intergalaktik/ulx5-PCIe-1x/README.md

# Work in progress!!! 

# ULX-PCIe
GateMate FPGA on PCIe card

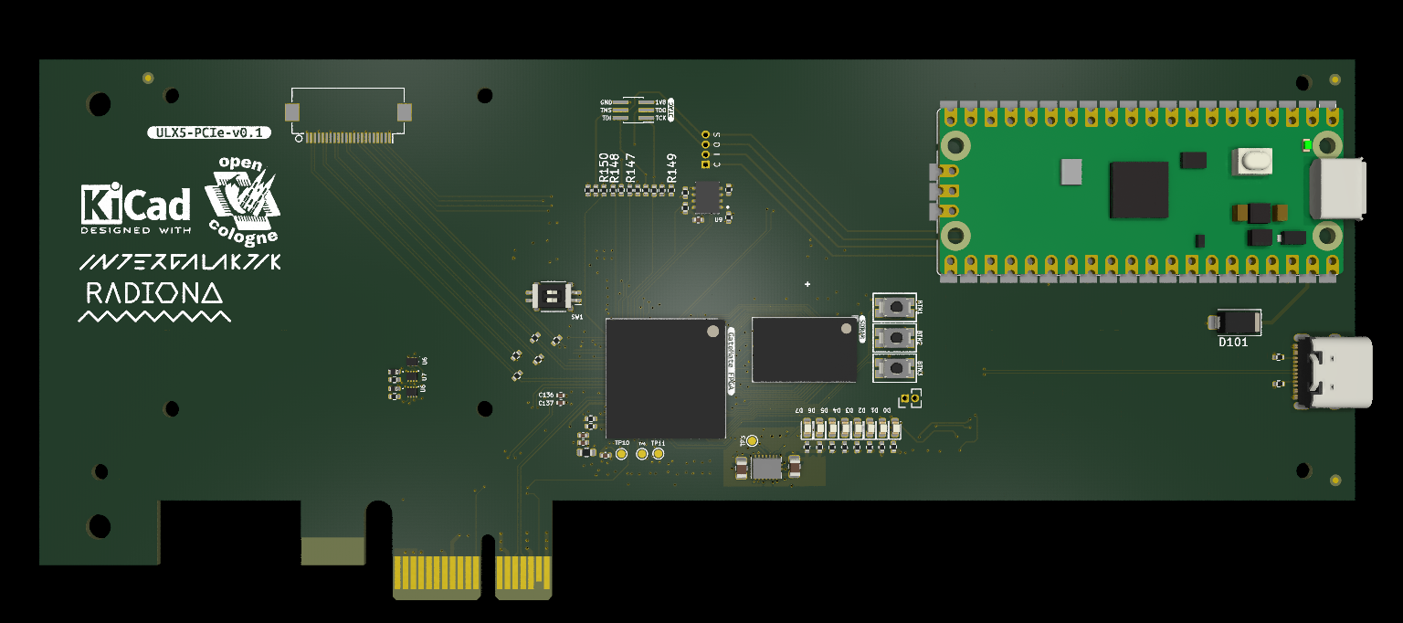
[picture p1: pic/PCIe_1X.png]
PCIE


## References

https://github.com/intergalaktik/ulx5m-gs

https://github.com/OLIMEX/GateMateA1-EVB

https://github.com/intergalaktik/Extension_Boards_for_Olimex_GateMate

https://github.com/YosysHQ/prjpeppercorn-test-cases

https://github.com/YosysHQ/prjpeppercorn
  
https://github.com/chili-chips-ba/openCologne

https://www.chili-chips.xyz/open-cologne

## Acknowledgements

This project was done in collaboration with Chili Chips*Ba team. 
They have put enormes effort in making all cores to work on GateMate even before we have our own board!
Thanks to them now we have big set of cores that can be used to check and improve opensource toolchain!
They are proven to be reliable partners that solves problem quickly and on side works on educating younger generations!
Also big thanks goes to YosysHQ as they are doing miracles with open source tooling, and we now finaly have one that works for GateMate!
From YosysHQ special thanks to Micko and Lofty that are helping in real time on Discord!
Special thanks to Patrick from Cologne, as without him and rest of Cologne team we would not be able to get this project done.

## Work on this board is financed by NLnet foundation

NLnet

https://nlnet.nl/project/openCologne/

https://nlnet.nl/project/OpenCologne-PCIe/

https://github.com/chili-chips-ba/openCologne-PCIE

This project was funded through the NGI0 Commons Fund, a fund established by NLnet with financial support from the European Commission's Next Generation Internet programme, under the aegis of DG Communications Networks, Content and Technology under grant agreement No 101135429. Additional funding is made available by the Swiss State Secretariat for Education, Research and Innovation (SERI).

## Check up our blogposts
Comming soon!!!

## Contact us

Discord: https://discord.gg/qwMUk6W
