intergalaktik/ulx5-PCIe-1x/ulx5-PCIe-1x.pdf

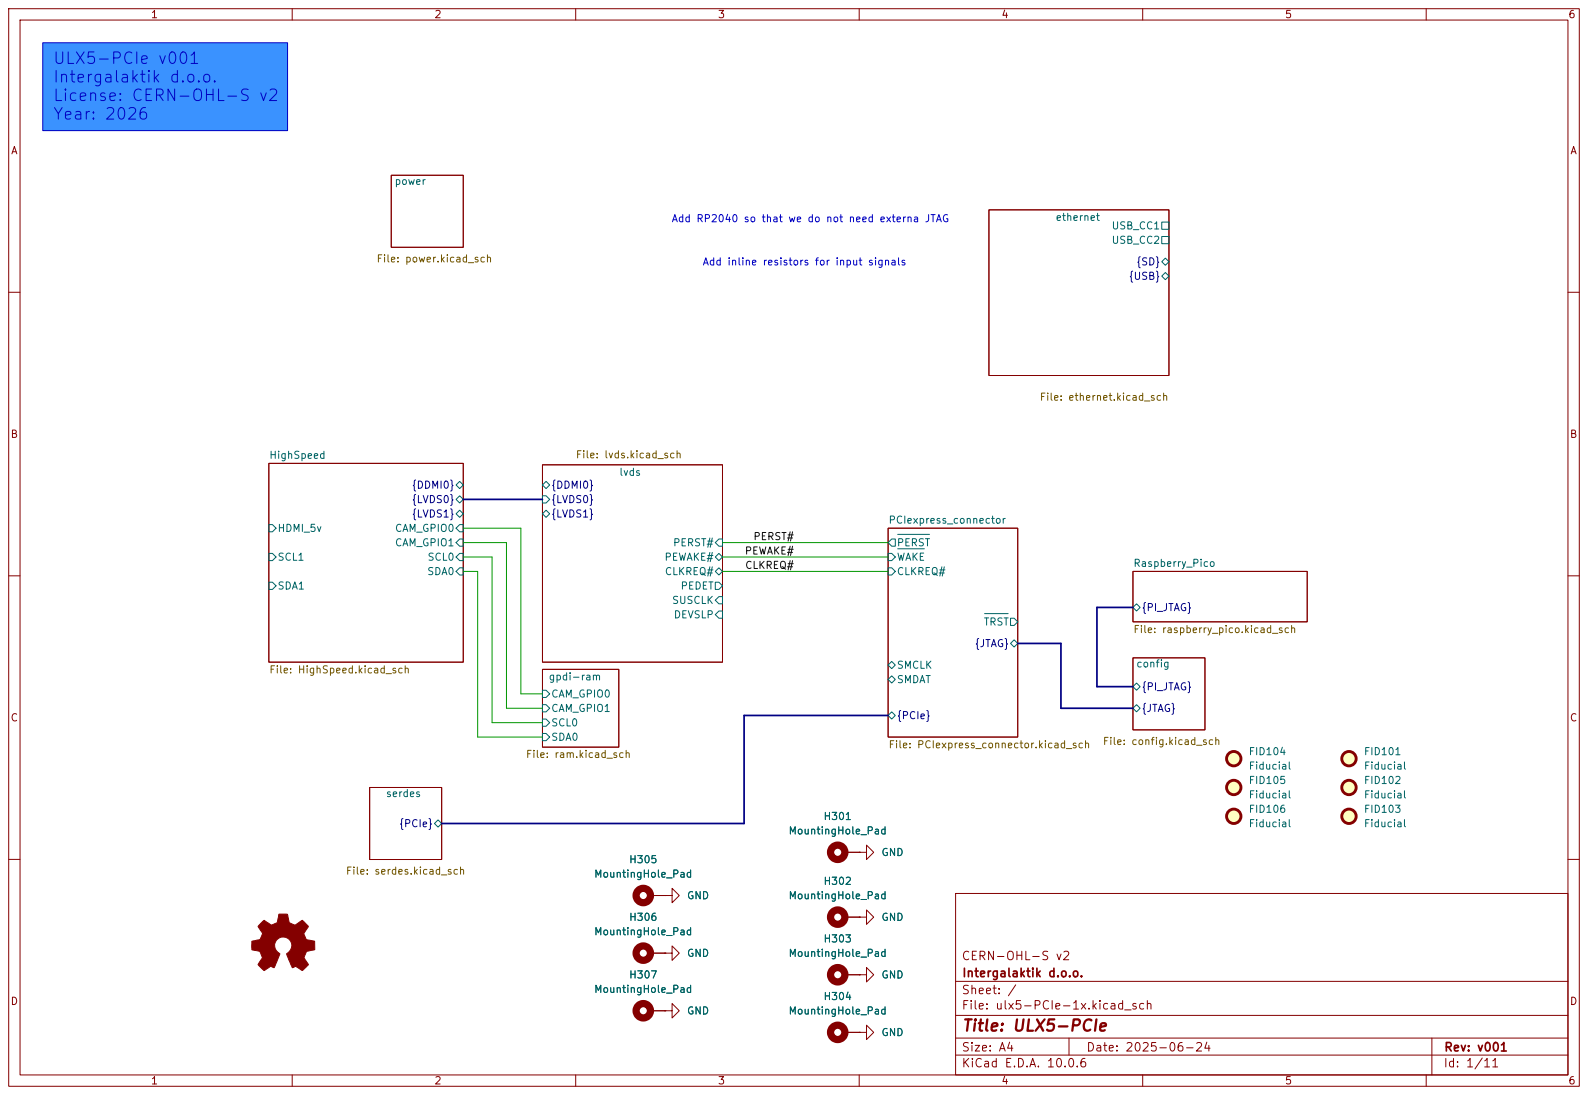
[picture p2: page 1]

Add RP2040 so that we do not need externa JTAG Add inline resistors for input signals H301 MountingHole_PadGND H302 MountingHole_PadGND
lvds File: lvds.kicad_sch CAM_GPIO0 CAM_GPIO1

{USB} ethernet File: ethernet.kicad_sch CLKREQ#

{PCIe} serdes File: serdes.kicad_sch

Size: A4 | Rev: v001
KiCad E.D.A. 10.0.6 | Id: 1/11

1 | 2 | 3 | 4 | 5 | 6 1 | 2 | 3 | 4 | 5 | 6 ABCD | ABCD Date: 2025-06-24

## Title: ULX5-PCIe

### File: raspberry_pico.kicad_sch

### Sheet: /Raspberry_Pico/

Intergalaktik d.o.o.

### CERN-OHL-S v2

# +3V3D301 D_Schottky GND

GND

GPIO0 1 | GPIO1 2 | GND 3 GPIO2 4 | GPIO3 5 | GPIO4 6 | GPIO5 7 | GPIO6 9 | GPIO7 10 | GPIO8 11 | GPIO9 12 | GPIO10 14 | GPIO11 15 | GPIO12 16 | GPIO13 17 | GPIO14 19 | GPIO15 20 | GPIO16 | 21 GPIO17 | 22 GPIO18 | 24 GPIO19 | 25 GPIO20 | 26 GPIO21 | 27 GPIO22 | 29 RUN 30 | GPIO26_ADC0 | 31 GPIO27_ADC1 | 32
AGND | 33 GPIO28_ADC2 | 34
ADC_VREF | 35 3V3 36
3V3_EN 37 | VSYS 39 | VBUS 40

SWCLK D1

SWDIO D3 | USB_GND | TP1 USB_DM | TP2 USB_DP | TP3
SMPS_PS | TP4
LED_OUT | TP5 BOOTSEL TP6
A101 RaspberryPi_Pico {PI_JTAG} | RST_N

FPGA_GPIO1

FPGA_UART_TX

FPGA_GPIO2

FPGA_UART_RX | GPIO10 | GPIO20 GPIO16 GPIO26 GPIO28 GPIO27 GPIO19 GPIO18 GPIO22 GPIO14 GPIO15 GPIO12 GPIO13 GPIO9 GPIO11 GPIO8 GPIO6 GPIO7 GPIO0 | GPIO21 GPIO20 | GPIO1 GPIO2 PI_TCK

PI_TDI PI_TDO

GPIO3 GPIO5 GPIO12 GPIO22 GPIO21 PI_TMS GPIO13GPIO17 GPIO18 GPIO16 GPIO19 | GPIO4 | GPIO17 GND
A101 RaspberryPi_Pico GPIO0 1 | GPIO1 2 | GND 3 GPIO2 4 | GPIO3 5 | GPIO4 6 | GPIO5 7 | GPIO6 9 | GPIO7 10 | GPIO8 11 | GPIO9 12 | GPIO10 14 | GPIO11 15 | GPIO12 16 | GPIO13 17 | GPIO14 19 | GPIO15 20 | GPIO16 | 21 GPIO17 | 22 GPIO18 | 24 GPIO19 | 25 GPIO20 | 26 GPIO21 | 27 GPIO22 | 29 RUN 30 | GPIO26_ADC0 | 31 GPIO27_ADC1 | 32
AGND | 33 GPIO28_ADC2 | 34
ADC_VREF | 35 3V3 36
3V3_EN 37 | VSYS 39 | VBUS 40

SWCLK D1

SWDIO D3 | USB_GND | TP1 USB_DM | TP2 USB_DP | TP3
SMPS_PS | TP4
LED_OUT | TP5 BOOTSEL TP6 | D301 D_Schottky +3V3

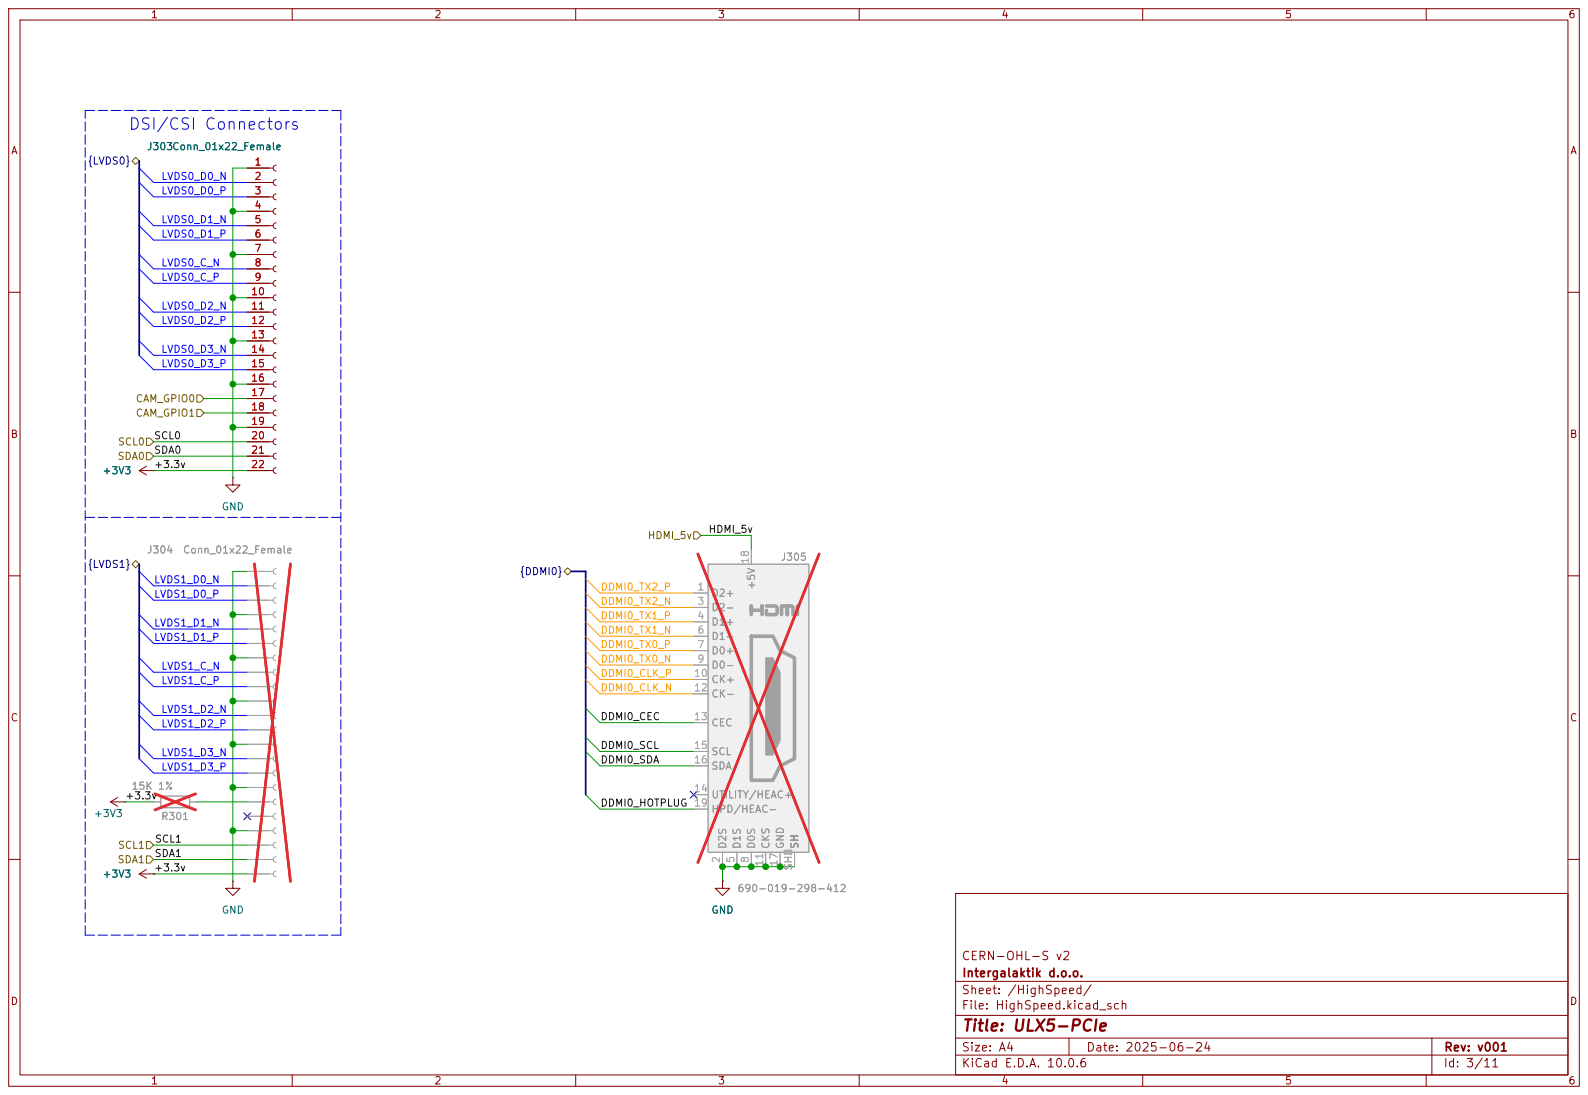
[picture p3: page 3]

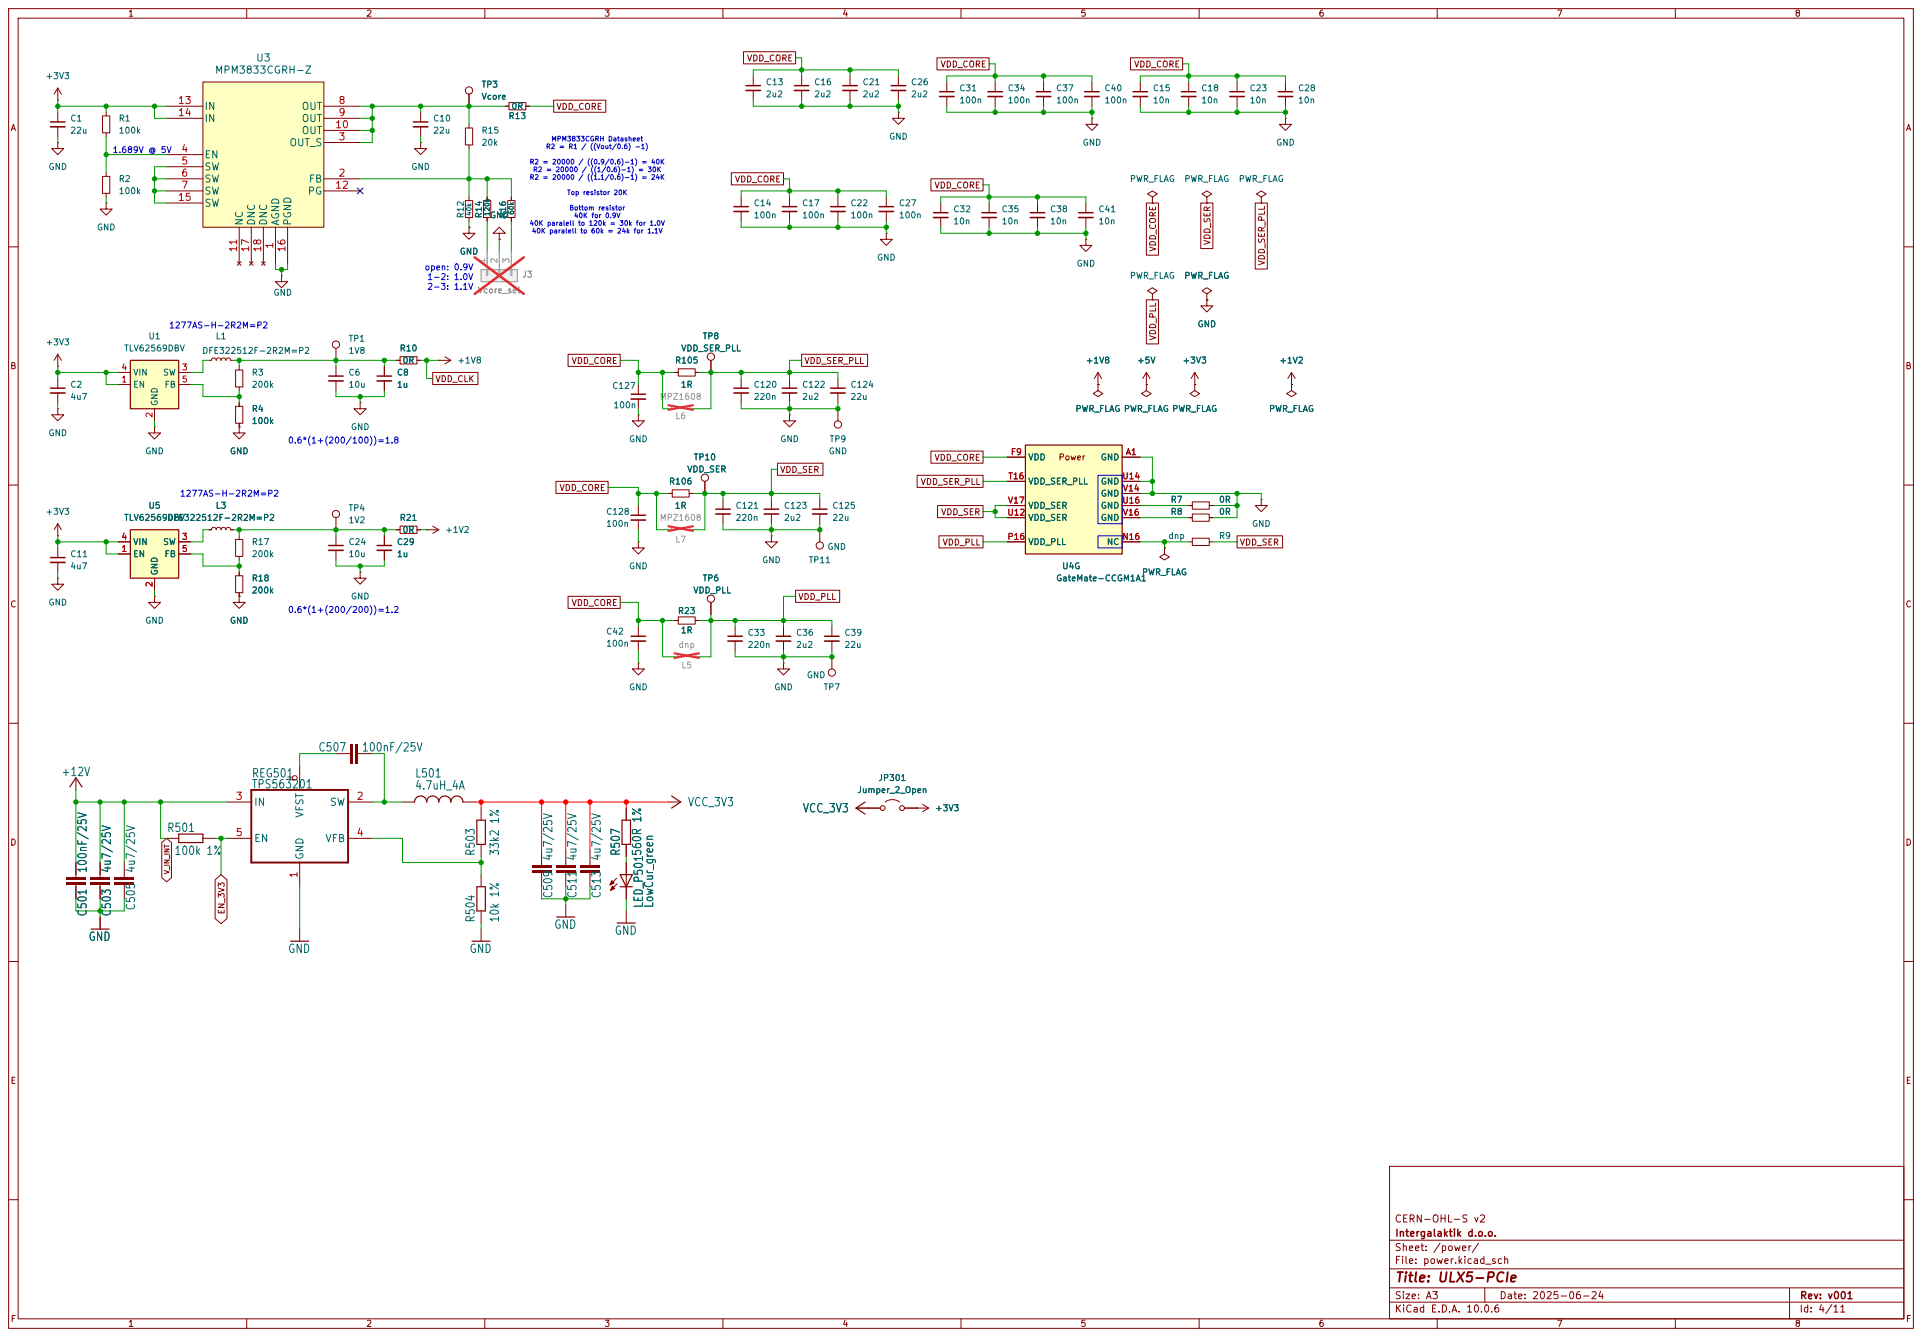
[picture p4: page 4]

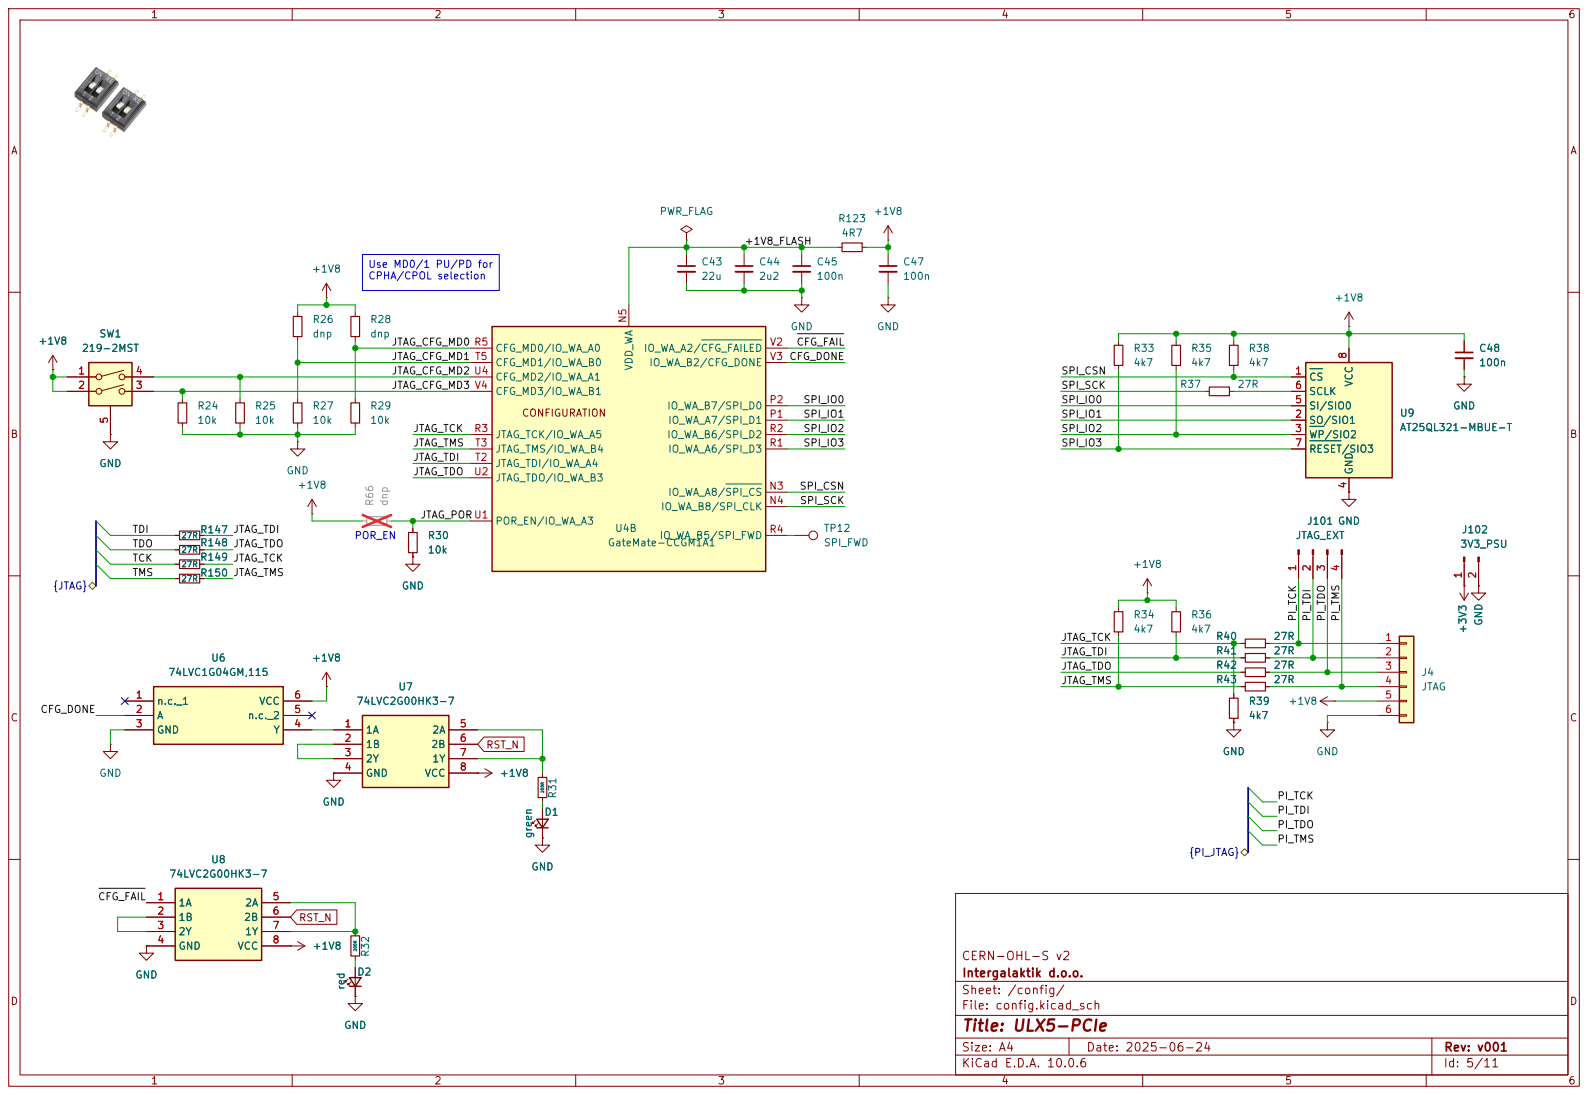
[picture p5: page 5]

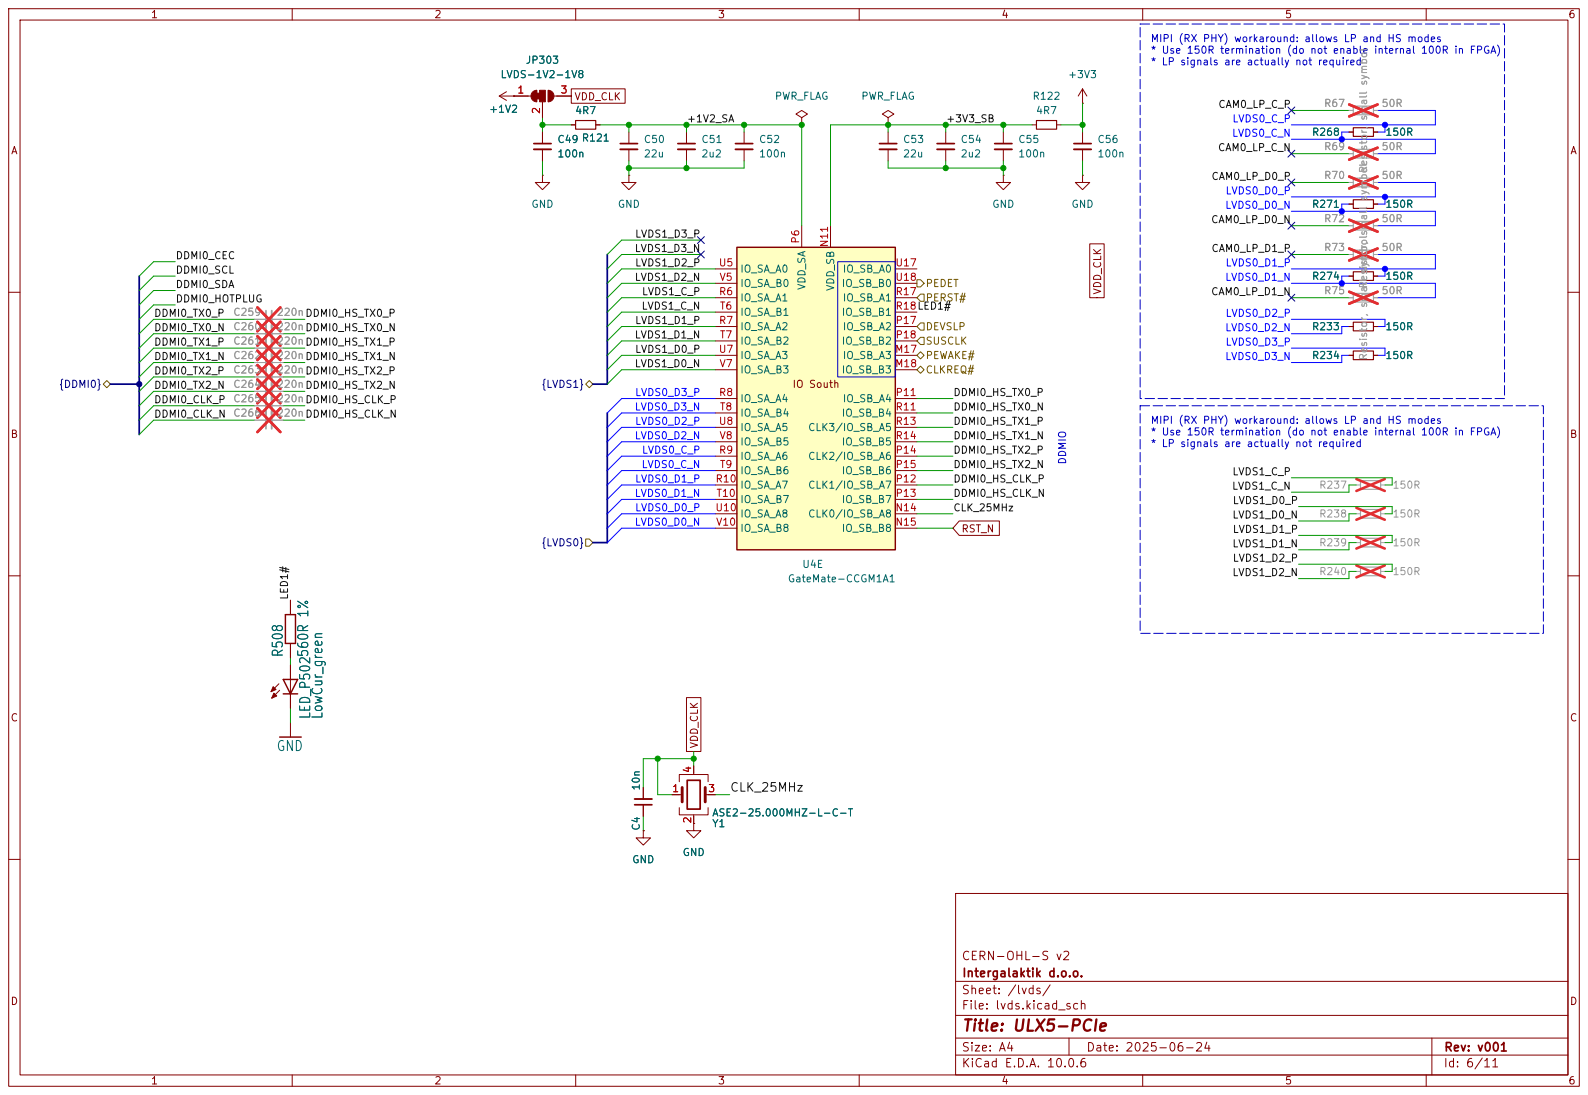
[picture p6: page 6]

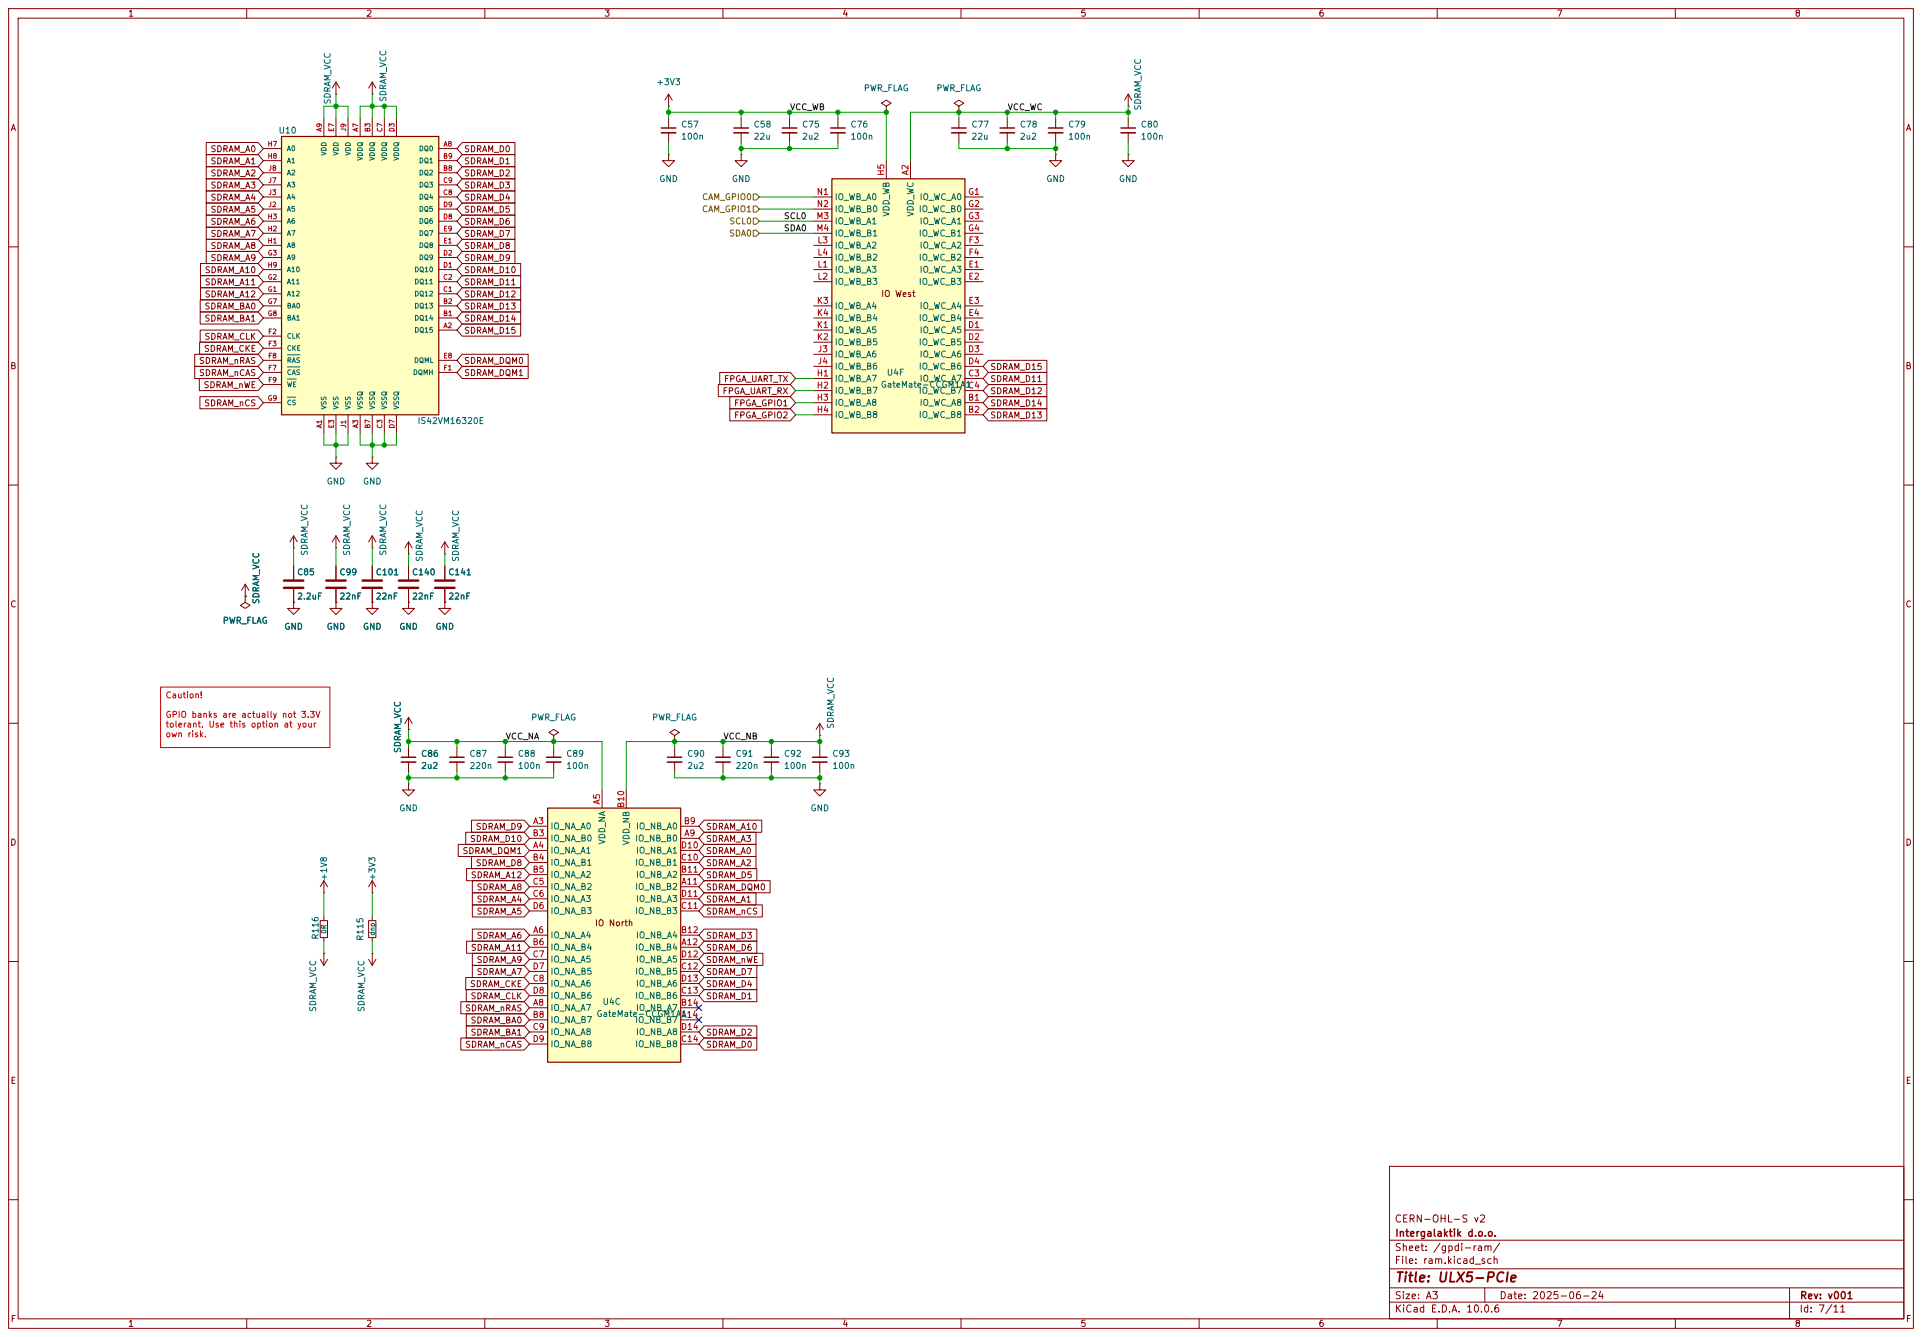
[picture p7: page 7]

Caution! GPIO banks are actually not 3.3V

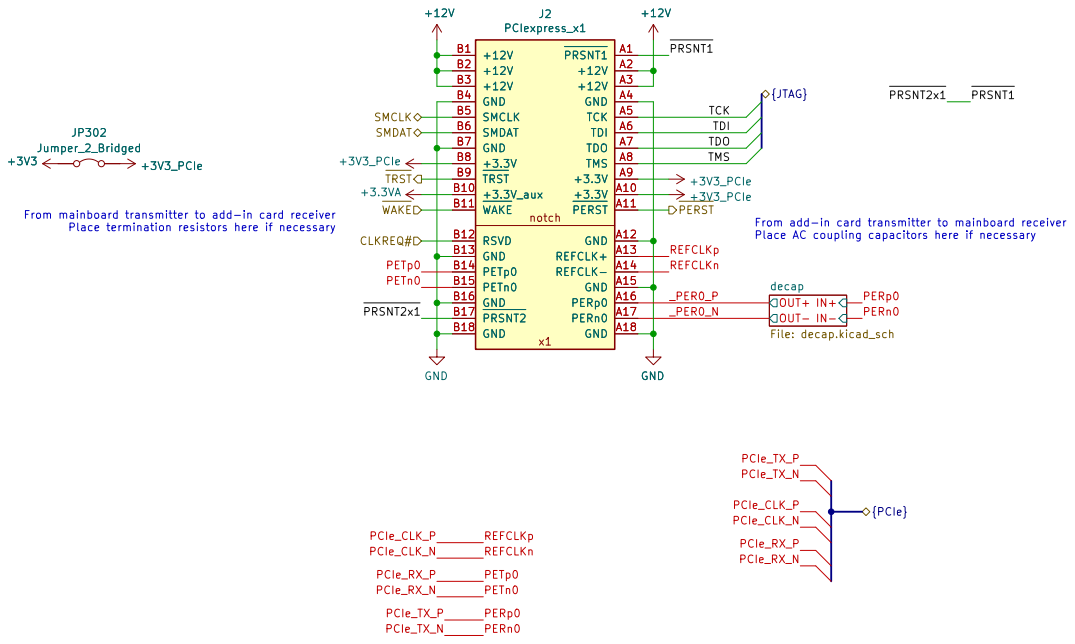
[picture p8: page 8]

Jumper_2_Bridged +3V3
From add-in card transmitter to mainboard receiver Place AC coupling capacitors here if necessary From mainboard transmitter to add-in card receiver Place termination resistors here if necessary +3V3_PCIe

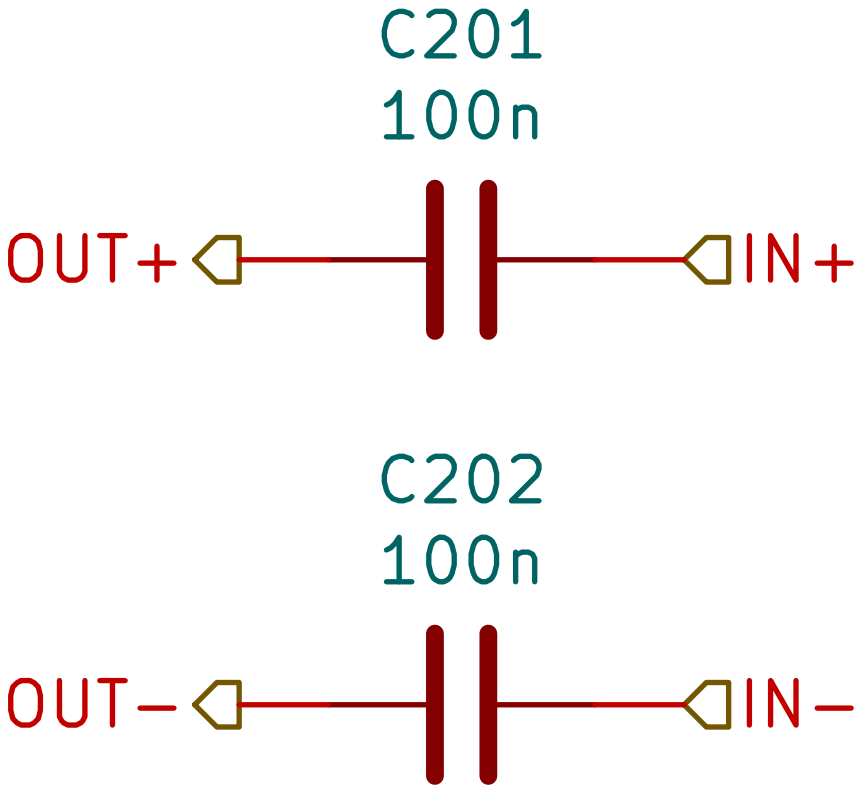
[picture p9: page 9]

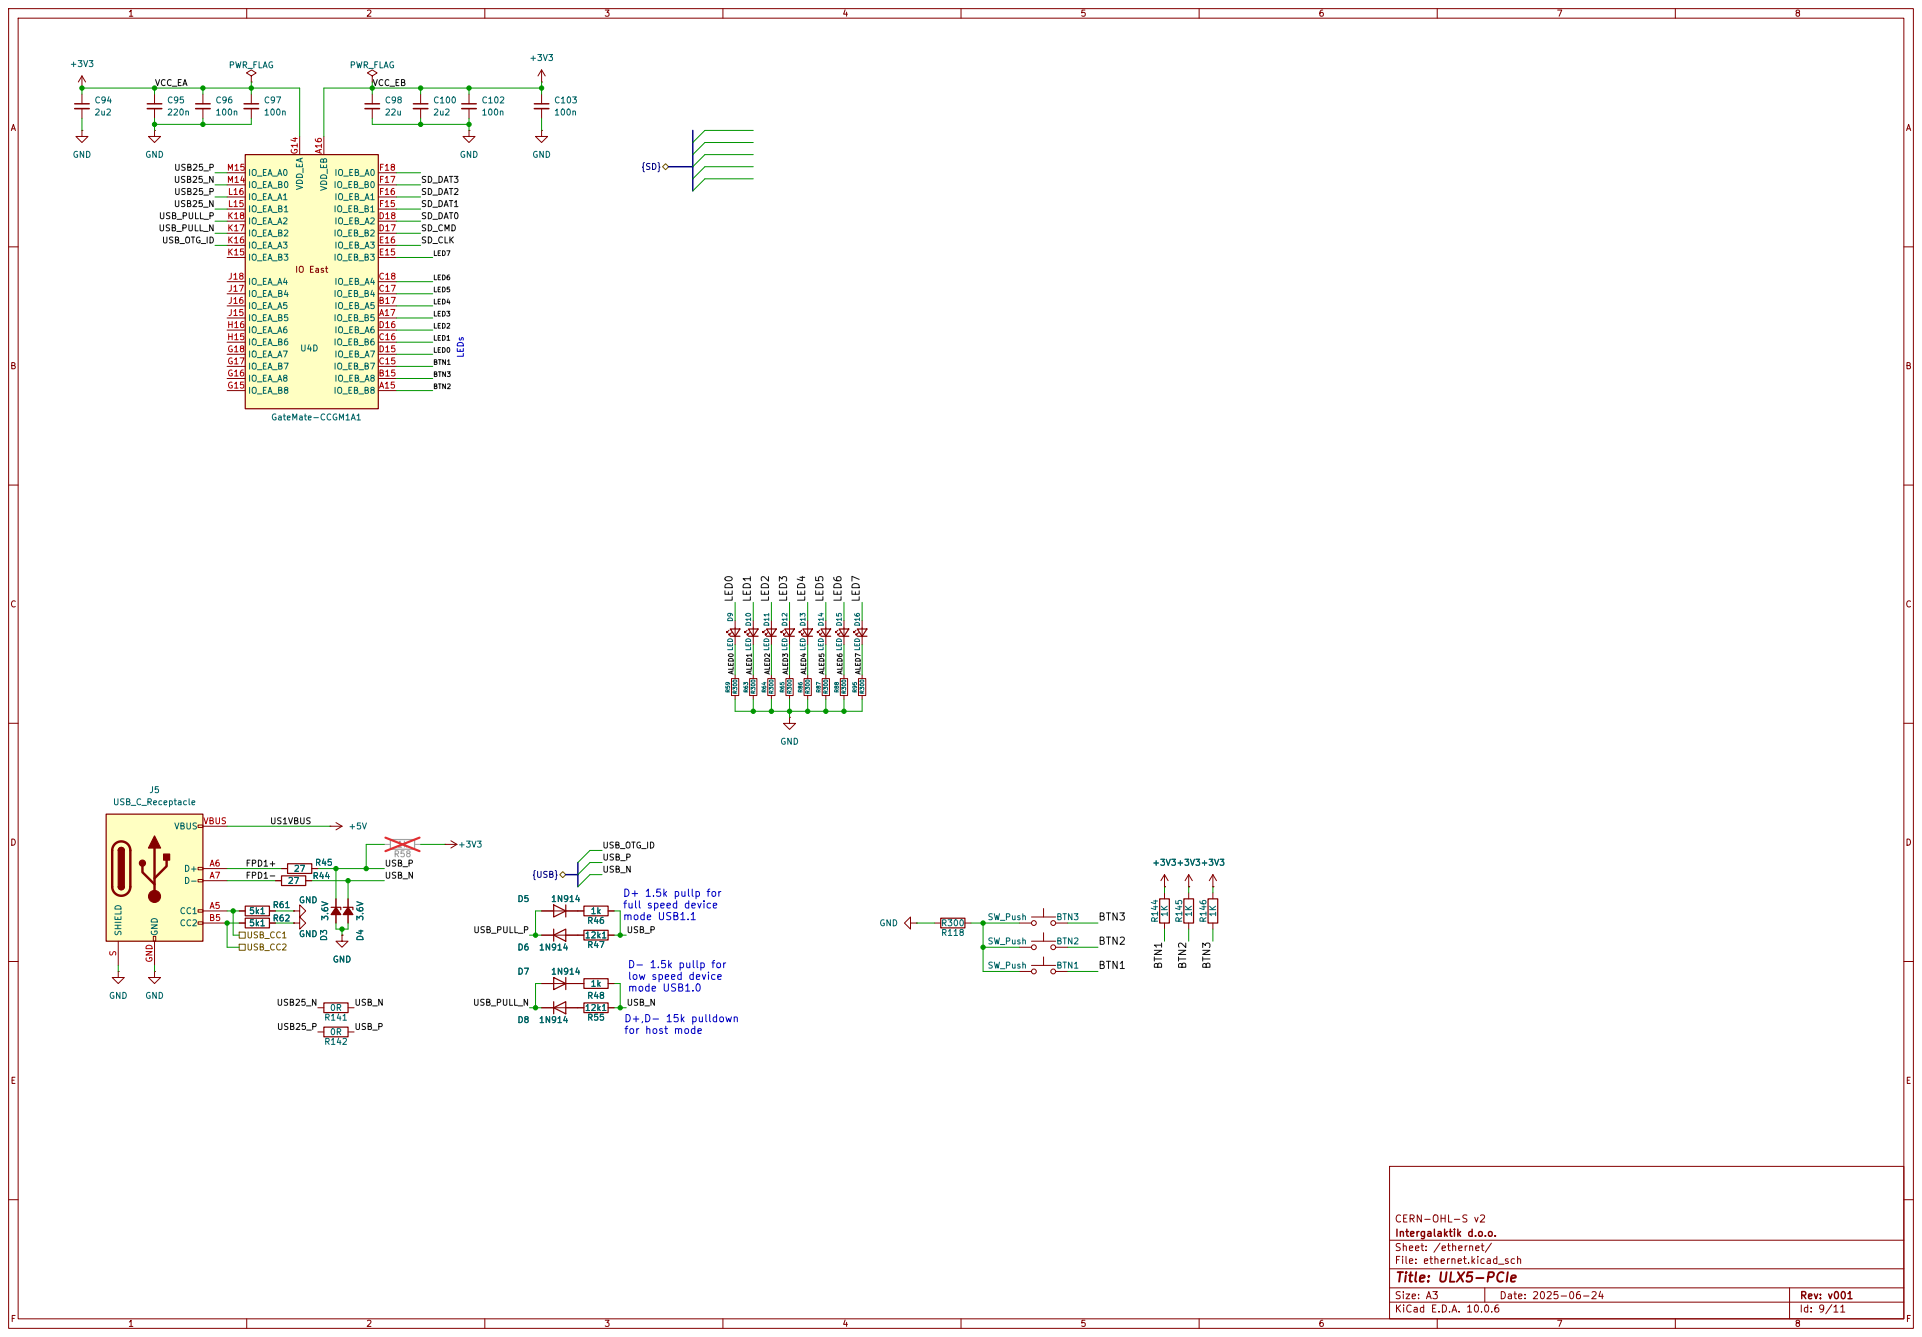
[picture p10: page 10]

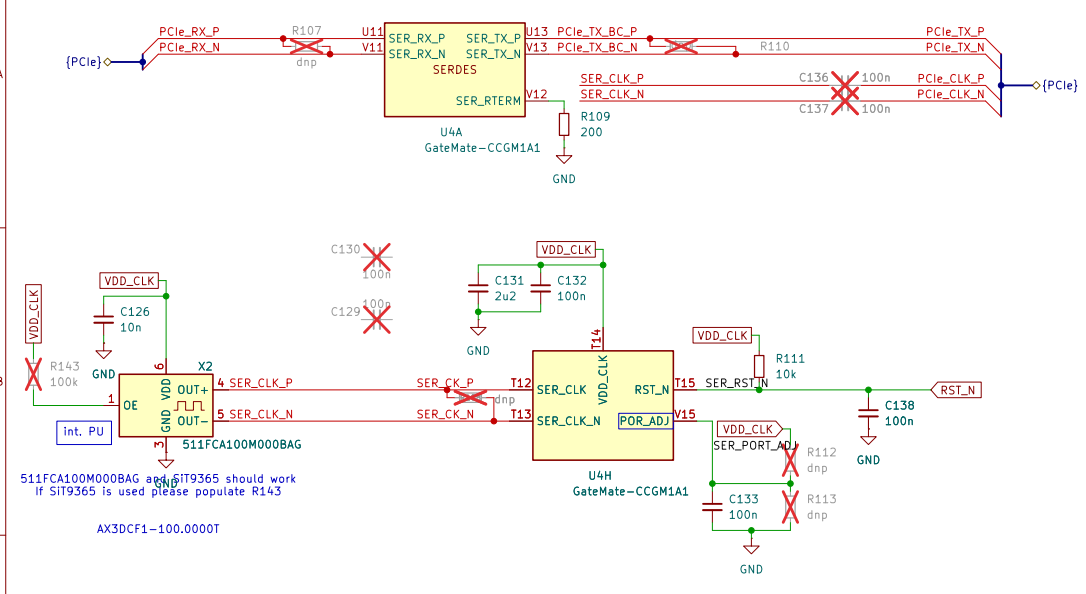
[picture p11: page 11]

511FCA100M000BAG and SiT9365 should work
If SiT9365 is used please populate R143
