intergalaktik/ulx5-PCIe-1x/ulx5-PCIe-1x.kicad_pcb

## KiCad design ulx5-PCIe-1x.kicad_pcb (2026-10-30)

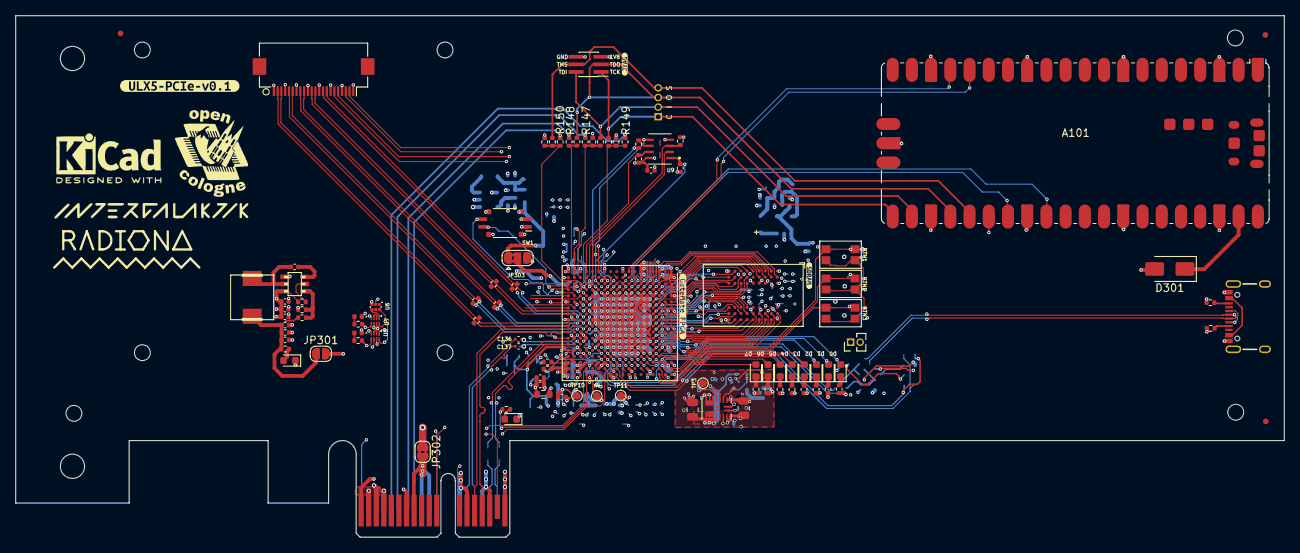
[picture p12: board ulx5-PCIe-1x.kicad_pcb from above]

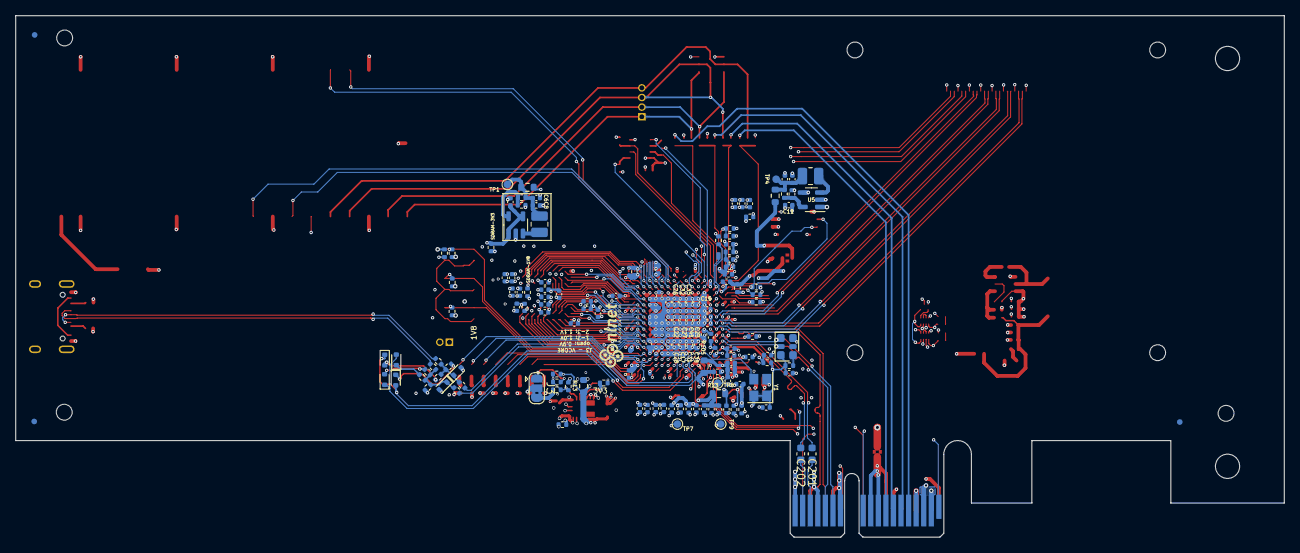
[picture p13: board ulx5-PCIe-1x.kicad_pcb from below]

Board: 6 copper layers, 167.7 x 68.9 mm, 261 parts (149 on the bottom side), 183 nets.

Parts:
A101: RaspberryPi_Pico; RaspberryPi_Pico_SMD
BTN1, BTN2, BTN3: SW_Push; Switch_EVPAA
C1, C10: 22u; C_0805_2012Metric
C2, C11: 4u7; C_0402_1005Metric
C4, C15, C18, C23, C28, C32, C35, C38, C41, C126: 10n; C_0402_1005Metric
C6, C24: 10u; C_0402_1005Metric
C8, C29: 1u; C_0402_1005Metric
C13, C16, C21, C26, C36, C44, C51, C54, C75, C78, C86, C90, C94, C100, C122, C123, C131: 2u2; C_0402_1005Metric
C14, C17, C22, C27, C31, C34, C37, C40, C42, C45, C47, C48, C49, C52, C55, C56, C57, C76, C79, C80, C88, C89, C92, C93, C96, C97, C102, C103, C127, C128, C132, C133, C138: 100n; C_0402_1005Metric
C33, C87, C91, C95, C120, C121: 220n; C_0402_1005Metric
C39, C43, C50, C53, C58, C77, C98, C124, C125: 22u; C_0402_1005Metric
C85: 2.2uF; C_0402_1005Metric
C99, C101, C140, C141: 22nF; C_0402_1005Metric
C136, C137: 100n; C_0402_SI_M
C201, C202: 100n; C_0603_1608Metric
C501, C507: 100nF/25V; C_0402_1005Metric
C503, C505, C509, C511, C513: 4u7/25V; C_0402_1005Metric
D1: green; D_0402_1005Metric
D2: red; D_0402_1005Metric
D3, D4: 3.6V; D_SOD-523
D5, D6, D7, D8: 1N914; D_SOD-523
D9, D10, D11, D12, D13, D14, D15, D16: LED; LED_0603_1608Metric
D301: D_Schottky; D_SMA
FID101, FID102, FID103, FID104, FID105, FID106: Fiducial; Fiducial_0.75mm_Mask1.5mm
H301, H302, H303, H304, H305, H306, H307: MountingHole_Pad; MountingHole_2.1mm
J1: PCIexpress_bracket; PCIexpress_bracket_low
J2: PCIexpress_x1
J3: Vcore_sel; SolderJumper-3_P1.3mm_Bridged2Bar12_RoundedPad1.0x1.5mm
J4: JTAG; PinHeader_2x03_P1.00mm_Vertical_SMD
J5: USB_C_Receptacle; USB-C_16
J101: JTAG_EXT; PinHeader_1x04_P1.27mm_Vertical
J102: 3V3_PSU; PinHeader_1x02_P1.27mm_Vertical
J303: Conn_01x22_Female; Hirose_FH12-22S-0.5SH_1x22-1MP_P0.50mm_Horizontal
JP301: Jumper_2_Open; SolderJumper-2_P1.3mm_Open_RoundedPad1.0x1.5mm
JP302: Jumper_2_Bridged; SolderJumper-2_P1.3mm_Bridged2Bar_RoundedPad1.0x1.5mm
JP303: LVDS-1V2-1V8; SolderJumper-3_P1.3mm_Bridged2Bar12_RoundedPad1.0x1.5mm
L1, L3: DFE322512F-2R2M=P2; L_1008_2520Metric
L501: 4.7uH_4A; YSPI0530
LED_P501, LED_P502: LowCur_green; LED_0603_1608Metric
LoGo_opencologne: MountingHole; open_cologne_small
R1, R2, R4, R143: 100k; R_0402_1005Metric
R3, R17, R18: 200k; R_0402_1005Metric
R7, R8, R116, R141, R142: 0R; R_0402_1005Metric
R9, R66, R115: dnp; R_0402_1005Metric
R10, R13, R21: 0R; R_0603_1608Metric
R12: 40k; R_0402_1005Metric
R14: 120k; R_0402_1005Metric
R15: 20k; R_0402_1005Metric
R16: 60k; R_0402_1005Metric
R23, R105, R106: 1R; R_0603_1608Metric
R24, R25, R27, R29, R30, R111: 10k; R_0402_1005Metric
R31, R32: 200R; R_0402_1005Metric
R33, R34, R35, R36, R38, R39: 4k7; R_0402_1005Metric
R37, R40, R41, R42, R43, R147, R148, R149, R150: 27R; R_0402_1005Metric
R44, R45: 27; R_0402_1005Metric
R46, R48, R58: 1k; R_0402_1005Metric
R47, R55: 12k1; R_0402_1005Metric
R59, R63, R64, R65, R86, R87, R88, R95, R118: R300; R_0402_1005Metric
R61, R62: 5k1; R_0402_1005Metric
R109: 200; R_0402_1005Metric
R121, R122, R123: 4R7; R_0402_1005Metric
R144, R145, R146: 1K; R_0402_1005Metric
R233, R234, R268, R271, R274: 150R; R_0402_1005Metric
R501: 100k 1%; R_0402_1005Metric
R503: 33k2 1%; R_0402_1005Metric
R504: 10k 1%; R_0402_1005Metric
R507, R508: 560R 1%; R_0402_1005Metric
REG501: TPS563201; SOT-23-THIN
SW1: 219-2MST; SW_DIP_SPSTx02_Slide_Copal_CVS-02xB_W5.9mm_P1mm
TP1: 1V8; TestPoint_Pad_D1.0mm
TP3: Vcore; TestPoint_Pad_D1.0mm
TP4: 1V2; TestPoint_Pad_D1.0mm
TP6: VDD_PLL; TestPoint_Pad_D1.0mm
TP7, TP9, TP11: GND; TestPoint_Pad_D1.0mm
TP8: VDD_SER_PLL; TestPoint_Pad_D1.0mm
TP10: VDD_SER; TestPoint_Pad_D1.0mm
TP12: SPI_FWD; TestPoint_Pad_1.0x1.0mm
U1, U5: TLV62569DBV; SOT-23-5
U3: MPM3833CGRH-Z
U4: GateMate-CCGM1A1; BGA-324_15.0x15.0mm_Layout18x18_P0.8mm_Ball0.45mm_Pad0.4mm_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
U6: 74LVC1G04GM,115; PESD3V3L5UF115
U7, U8: 74LVC2G00HK3-7; 74LVC2G00HK37
U9: AT25QL321-MBUE-T; SON80P400X300X60-10N
U10: IS42VM16320E; IS42S16320D-6BLI
X2: 511FCA100M000BAG; Oscillator_SMD_SiTime_PQFD-6L_3.2x2.5mm
Y1: ASE2-25.000MHZ-L-C-T; Crystal_SMD_TXC_7M-4Pin_3.2x2.5mm
kibuzzard-6ADB8C37: G***; kibuzzard-6ADB8C37
kibuzzard-686AA7AF: G***; kibuzzard-686AA7AF
kibuzzard-686AA726: G***; kibuzzard-686AA726
kibuzzard-686CE423: G***; kibuzzard-686CE423
radiona: radiona

Connections:
+1V2: JP303.1 (A), R21.2
+3V3: C1.1, C2.1, C11.1, C56.1, C57.1, C58.1, C75.1, C76.1, C94.1, C95.1, C96.1, C97.1, C98.1, C100.1, C102.1, C103.1, D301.2 (A), J102.1, J303.22, JP301.2 (B), JP302.1 (A), R1.1, R58.2, R115.2, R122.2, R144.1, R145.1, R146.1, U1.1 (EN), U1.4 (VIN), U3.13 (IN), U3.14 (IN), U4.A16 (VDD_EB), U4.B18 (VDD_EB), U4.E14 (VDD_EB), U4.E17 (VDD_EB), U4.F13 (VDD_EB), U4.G14 (VDD_EA), U4.H5 (VDD_WB), U4.H17 (VDD_EA), U4.J2 (VDD_WB), U4.J14 (VDD_EA), U4.K5 (VDD_WB), U4.L14 (VDD_EA), U4.L17 (VDD_EA), U4.M2 (VDD_WB), U4.M5 (VDD_WB), U5.1 (EN), U5.4 (VIN)
+3V3_PCIe: J2.A9 (+3.3V), J2.A10 (+3.3V), J2.B8 (+3.3V), JP302.2 (B)
/CLKREQ#: J2.B12 (RSVD), U4.M18 (IO_SB_B3)
/HighSpeed/CAM_GPIO0: J303.17, U4.N1 (IO_WB_A0)
/HighSpeed/CAM_GPIO1: J303.18, U4.N2 (IO_WB_B0)
/HighSpeed/LVDS0_C_N: J303.8, R268.2, U4.T9 (IO_SA_B6)
/HighSpeed/LVDS0_C_P: J303.9, R268.1, U4.R9 (IO_SA_A6)
/HighSpeed/LVDS0_D0_N: J303.2, R271.2, U4.V10 (IO_SA_B8)
/HighSpeed/LVDS0_D0_P: J303.3, R271.1, U4.U10 (IO_SA_A8)
/HighSpeed/LVDS0_D1_N: J303.5, R274.2, U4.T10 (IO_SA_B7)
/HighSpeed/LVDS0_D1_P: J303.6, R274.1, U4.R10 (IO_SA_A7)
/HighSpeed/LVDS0_D2_N: J303.11, R233.2, U4.V8 (IO_SA_B5)
/HighSpeed/LVDS0_D2_P: J303.12, R233.1, U4.U8 (IO_SA_A5)
/HighSpeed/LVDS0_D3_N: J303.14, R234.2, U4.T8 (IO_SA_B4)
/HighSpeed/LVDS0_D3_P: J303.15, R234.1, U4.R8 (IO_SA_A4)
/HighSpeed/SCL0: J303.20, U4.M3 (IO_WB_A1)
/HighSpeed/SDA0: J303.21, U4.M4 (IO_WB_B1)
/PCIexpress_connector/PCIe_CLK_N: C137.2, J2.A14 (REFCLK-)
/PCIexpress_connector/PCIe_CLK_P: C136.2, J2.A13 (REFCLK+)
/PCIexpress_connector/PCIe_RX_N: J2.B15 (PETn0), U4.V11 (SER_RX_N)
/PCIexpress_connector/PCIe_RX_P: J2.B14 (PETp0), U4.U11 (SER_RX_P)
/PCIexpress_connector/PCIe_TX_N: C202.2, U4.V13 (SER_TX_N)
/PCIexpress_connector/PCIe_TX_P: C201.1, U4.U13 (SER_TX_P)
/PCIexpress_connector/TCK: J2.A5 (TCK), R149.1
/PCIexpress_connector/TDI: J2.A6 (TDI), R147.1
/PCIexpress_connector/TDO: J2.A7 (TDO), R148.1
/PCIexpress_connector/TMS: J2.A8 (TMS), R150.1
/PCIexpress_connector/_PER0_N: C202.1, J2.A17 (PERn0)
/PCIexpress_connector/_PER0_P: C201.2, J2.A16 (PERp0)
/PCIexpress_connector/~PRSNT1: J2.A1 (~PRSNT1), J2.B17 (~PRSNT2)
/PERST#: J2.A11 (~PERST), U4.R17 (IO_SB_A1)
/PEWAKE#: J2.B11 (~WAKE), U4.M17 (IO_SB_A3)
/Raspberry_Pico/PI_TCK: A101.21 (GPIO16), J4.1, J101.1, R40.2
/Raspberry_Pico/PI_TDI: A101.22 (GPIO17), J4.2, J101.2, R41.2
/Raspberry_Pico/PI_TDO: A101.24 (GPIO18), J4.3, J101.3, R42.2
/Raspberry_Pico/PI_TMS: A101.25 (GPIO19), J4.4, J101.4, R43.2
/config/+1V8_FLASH: C43.1, C44.1, C45.1, R123.1, U4.N5 (VDD_WA), U4.P3 (VDD_WA), U4.P5 (VDD_WA), U4.T1 (VDD_WA), U4.U3 (VDD_WA)
/config/CFG_DONE: U4.V3 (IO_WA_B2/CFG_DONE), U6.2 (A)
/config/JTAG_CFG_MD0: R29.1, U4.R5 (CFG_MD0/IO_WA_A0)
/config/JTAG_CFG_MD1: R27.1, U4.T5 (CFG_MD1/IO_WA_B0)
/config/JTAG_CFG_MD2: R25.1, SW1.4, U4.U4 (CFG_MD2/IO_WA_A1)
/config/JTAG_CFG_MD3: R24.1, SW1.3, U4.V4 (CFG_MD3/IO_WA_B1)
/config/JTAG_POR: R30.1, R66.2, U4.U1 (POR_EN/IO_WA_A3)
/config/JTAG_TCK: R39.1, R40.1, R149.2, U4.R3 (JTAG_TCK/IO_WA_A5)
/config/JTAG_TDI: R36.2, R41.1, R147.2, U4.T2 (JTAG_TDI/IO_WA_A4)
/config/JTAG_TDO: R42.1, R148.2, U4.U2 (JTAG_TDO/IO_WA_B3)
/config/JTAG_TMS: R34.2, R43.1, R150.2, U4.T3 (JTAG_TMS/IO_WA_B4)
/config/SPI_CSN: R38.2, U4.N3 (IO_WA_A8/~SPI_CS), U9.1 (~CS)
/config/SPI_IO0: U4.P2 (IO_WA_B7/SPI_D0), U9.5 (SI/SIO0)
/config/SPI_IO1: U4.P1 (IO_WA_A7/SPI_D1), U9.2 (SO/SIO1)
/config/SPI_IO2: R35.2, U4.R2 (IO_WA_B6/SPI_D2), U9.3 (~WP/SIO2)
/config/SPI_IO3: R33.2, U4.R1 (IO_WA_A6/SPI_D3), U9.7 (~RESET/SIO3)
/config/SPI_SCK: R37.1, U4.N4 (IO_WA_B8/SPI_CLK)
/config/~CFG_FAIL: U4.V2 (IO_WA_A2/~CFG_FAILED), U8.1 (1A)
/ethernet/ALED0: D9.1 (K), R59.1
/ethernet/ALED1: D10.1 (K), R63.1
/ethernet/ALED2: D11.1 (K), R64.1
/ethernet/ALED3: D12.1 (K), R65.1
/ethernet/ALED4: D13.1 (K), R86.1
/ethernet/ALED5: D14.1 (K), R87.1
/ethernet/ALED6: D15.1 (K), R88.1
/ethernet/ALED7: D16.1 (K), R95.1
/ethernet/BTN1: BTN1.2, R144.2, U4.C15 (IO_EB_B7)
/ethernet/BTN2: BTN2.2, R145.2, U4.A15 (IO_EB_B8)
/ethernet/BTN3: BTN3.2, R146.2, U4.B15 (IO_EB_A8)
/ethernet/FPD1+: J5.A6 (D+), J5.B6 (D+), R45.2
/ethernet/FPD1-: J5.A7 (D-), J5.B7 (D-), R44.2
/ethernet/LED0: D9.2 (A), U4.D15 (IO_EB_A7)
/ethernet/LED1: D10.2 (A), U4.C16 (IO_EB_B6)
/ethernet/LED2: D11.2 (A), U4.D16 (IO_EB_A6)
/ethernet/LED3: D12.2 (A), U4.A17 (IO_EB_B5)
/ethernet/LED4: D13.2 (A), U4.B17 (IO_EB_A5)
/ethernet/LED5: D14.2 (A), U4.C17 (IO_EB_B4)
/ethernet/LED6: D15.2 (A), U4.C18 (IO_EB_A4)
/ethernet/LED7: D16.2 (A), U4.E15 (IO_EB_B3)
/ethernet/USB25_N: R141.1, U4.L15 (IO_EA_B1), U4.M14 (IO_EA_B0)
/ethernet/USB25_P: R142.1, U4.L16 (IO_EA_A1), U4.M15 (IO_EA_A0)
/ethernet/USB_CC1: J5.A5 (CC1), R61.2
/ethernet/USB_CC2: J5.B5 (CC2), R62.2
/ethernet/USB_N: D4.1 (K), R44.1, R48.1, R55.2, R141.2
/ethernet/USB_P: D3.1 (K), R45.1, R46.2, R47.2, R58.1, R142.2
/ethernet/USB_PULL_N: D7.2 (A), D8.1 (K), U4.K17 (IO_EA_B2)
/ethernet/USB_PULL_P: D5.2 (A), D6.1 (K), U4.K18 (IO_EA_A2)
/lvds/+1V2_SA: C50.1, C51.1, C52.1, R121.2, U4.P6 (VDD_SA), U4.P8 (VDD_SA), U4.P10 (VDD_SA), U4.U6 (VDD_SA), U4.U9 (VDD_SA)
/lvds/+3V3_SB: C53.1, C54.1, C55.1, R122.1, U4.N11 (VDD_SB), U4.N13 (VDD_SB), U4.N18 (VDD_SB), U4.R15 (VDD_SB), U4.T18 (VDD_SB)
/lvds/CLK_25MHz: U4.N14 (CLK0/IO_SB_A8), Y1.3
/lvds/LED1#: R508.2, U4.R18 (IO_SB_B1)
/serdes/SER_CK_N: C137.1, U4.T13 (SER_CLK_N), X2.5 (OUT-)
/serdes/SER_CK_P: C136.1, U4.T12 (SER_CLK), X2.4 (OUT+)
/serdes/SER_PORT_ADJ: C133.1, U4.V15 (POR_ADJ)
EN_3V3: R501.2, REG501.5 (EN)
FPGA_GPIO1: A101.29 (GPIO22), U4.H3 (IO_WB_A8)
FPGA_GPIO2: A101.27 (GPIO21), U4.H4 (IO_WB_B8)
FPGA_UART_RX: A101.16 (GPIO12), U4.H2 (IO_WB_B7)
FPGA_UART_TX: A101.17 (GPIO13), U4.H1 (IO_WB_A7)
GND: A101.3 (GND), A101.8 (GND), A101.13 (GND), A101.18 (GND), A101.23 (GND), A101.28 (GND), A101.33 (AGND), A101.38 (GND), A101.D2 (GND), C1.2, C2.2, C4.1, C6.2, C8.2, C10.2, C11.2, C13.2, C14.2, C15.2, C16.2, C17.2, C18.2, C21.2, C22.2, C23.2, C24.2, C26.2, C27.2, C28.2, C29.2, C31.2, C32.2, C33.2, C34.2, C35.2, C36.2, C37.2, C38.2, C39.2, C40.2, C41.2, C42.2, C43.2, C44.2, C45.2, C47.2, C48.2, C49.2, C50.2, C51.2, C52.2, C53.2, C54.2, C55.2, C56.2, C57.2, C58.2, C75.2, C76.2, C77.2, C78.2, C79.2, C80.2, C85.2, C86.2, C87.2, C88.2, C89.2, C90.2, C91.2, C92.2, C93.2, C94.2, C95.2, C96.2, C97.2, C98.2, C99.2, C100.2, C101.2, C102.2, C103.2, C120.2, C121.2, C122.2, C123.2, C124.2, C125.2, C126.2, C127.2, C128.2, C131.2, C132.2, C133.2, C138.2, C140.2, C141.2, C501.2, C503.2, C505.2, C509.2, C511.2, C513.2, D1.1 (K), D2.1 (K), D3.2 (A), D4.2 (A), J2.A4 (GND), J2.A12 (GND), J2.A15 (GND), J2.A18 (GND), J2.B4 (GND), J2.B7 (GND), J2.B13 (GND), J2.B16 (GND), J2.B18 (GND), J3.2, J4.6, J5.GND, J5.S (SHIELD), J102.2, J303.1, J303.4, J303.7, J303.10, J303.13, J303.16, J303.19, LED_P501.1, LED_P502.1, R2.2, R4.2, R7.2, R8.2, R12.1, R18.2, R24.2, R25.2, R27.2, R29.2, R30.2, R39.2, R59.2, R61.1, R62.1, R63.2, R64.2, R65.2, R86.2, R87.2, R88.2, R95.2, R109.1, R118.2, R504.1, REG501.1 (GND), SW1.5, TP7.1 (1_1), TP9.1 (1_1), TP11.1 (1_1), U1.2 (GND), U3.1 (AGND), U3.16 (PGND), U4.A1 (GND), U4.A7 (GND), U4.A10 (GND), U4.A13 (GND), U4.A18 (GND), U4.B16 (GND), U4.C1 (GND), U4.E5 (GND), U4.E7 (GND), U4.E9 (GND), U4.E11 (GND), U4.E13 (GND), U4.E18 (GND), U4.F1 (GND), U4.F6 (GND), U4.F8 (GND), U4.F10 (GND), U4.F12 (GND), U4.F14 (GND), U4.G5 (GND), U4.G7 (GND), U4.G9 (GND), U4.G11 (GND), U4.G13 (GND), U4.H6 (GND), U4.H8 (GND), U4.H10 (GND), U4.H12 (GND), U4.H14 (GND), U4.H18 (GND), U4.J1 (GND), U4.J5 (GND), U4.J7 (GND), U4.J9 (GND), U4.J11 (GND), U4.J13 (GND), U4.K6 (GND), U4.K8 (GND), U4.K10 (GND), U4.K12 (GND), U4.K14 (GND), U4.L5 (GND), U4.L7 (GND), U4.L9 (GND), U4.L11 (GND), U4.L13 (GND), U4.L18 (GND), U4.M1 (GND), U4.M6 (GND), U4.M8 (GND), U4.M10 (GND), U4.M12 (GND), U4.M16 (GND), U4.N7 (GND), U4.N9 (GND), U4.N12 (GND), U4.N17 (GND), U4.P4 (GND), U4.P7 (GND), U4.P9 (GND), U4.R12 (GND), U4.R16 (GND), U4.T4 (GND), U4.T11 (GND), U4.T17 (GND), U4.U14 (GND), U4.U15 (GND), U4.V1 (GND), U4.V6 (GND), U4.V9 (GND), U4.V14 (GND), U4.V18 (GND), U5.2 (GND), U6.3 (GND), U7.4 (GND), U8.4 (GND), U9.4 (GND), U10.A1 (VSS), U10.A3 (VSSQ), U10.B7 (VSSQ), U10.C3 (VSSQ), U10.D7 (VSSQ), U10.E3 (VSS), U10.J1 (VSS), X2.3 (GND), Y1.2
unnamed: A101.39 (VSYS), D301.1 (K)
unnamed: BTN1.1, BTN2.1, BTN3.1, R118.1
unnamed: C6.1, C8.1, L1.2, R3.1, R10.1, TP1.1 (1_1)
unnamed: C24.1, C29.1, L3.2, R17.1, R21.1, TP4.1 (1_1)
unnamed: D1.2 (A), R31.2
unnamed: D2.2 (A), R32.2
unnamed: D5.1 (K), R46.1
unnamed: D6.2 (A), R47.1
unnamed: D7.1 (K), R48.2
unnamed: D8.2 (A), R55.1
unnamed: J3.1, R14.1
unnamed: J3.3, R16.1
unnamed: C49.1, JP303.2 (C), R121.1
unnamed: LED_P501.2, R507.1
unnamed: LED_P502.2, R508.1
unnamed: R7.1, U4.U16 (GND)
unnamed: R8.1, U4.V16 (GND)
unnamed: C507.1, L501.1, REG501.2 (SW)
unnamed: R503.1, R504.2, REG501.4 (VFB)
unnamed: C507.2, REG501.6 (VFST)
unnamed: R3.2, R4.1, U1.5 (FB)
unnamed: L1.1, U1.3 (SW)
unnamed: R1.2, R2.1, U3.4 (EN)
unnamed: R12.2, R14.2, R15.2, R16.2, U3.2 (FB)
unnamed: C10.1, R13.1, R15.1, TP3.1 (1_1), U3.3 (OUT_S), U3.8 (OUT), U3.9 (OUT), U3.10 (OUT)
unnamed: U3.5 (SW), U3.6 (SW), U3.7 (SW), U3.15 (SW)
unnamed: R109.2, U4.V12 (SER_RTERM)
unnamed: TP12.1 (1_1), U4.R4 (IO_WA_B5/SPI_FWD)
unnamed: R9.1, U4.N16 (NC)
unnamed: R17.2, R18.1, U5.5 (FB)
unnamed: L3.1, U5.3 (SW)
unnamed: U6.4 (Y), U7.1 (1A)
unnamed: U7.2 (1B), U7.3 (2Y)
unnamed: R31.1, U7.5 (2A), U7.7 (1Y)
unnamed: U8.2 (1B), U8.3 (2Y)
unnamed: R32.1, U8.5 (2A), U8.7 (1Y)
unnamed: R37.2, U9.6 (SCLK)
unnamed: R143.2, X2.1 (OE)
RST_N: A101.26 (GPIO20), C138.1, R111.2, U4.N15 (IO_SB_B8), U4.T15 (RST_N), U7.6 (2B), U8.6 (2B)
SDRAM_A0: U4.D10 (IO_NB_A1), U10.H7 (A0)
SDRAM_A1: U4.D11 (IO_NB_A3), U10.H8 (A1)
SDRAM_A2: U4.C10 (IO_NB_B1), U10.J8 (A2)
SDRAM_A3: U4.A9 (IO_NB_B0), U10.J7 (A3)
SDRAM_A4: U4.C6 (IO_NA_A3), U10.J3 (A4)
SDRAM_A5: U4.D6 (IO_NA_B3), U10.J2 (A5)
SDRAM_A6: U4.A6 (IO_NA_A4), U10.H3 (A6)
SDRAM_A7: U4.D7 (IO_NA_B5), U10.H2 (A7)
SDRAM_A8: U4.C5 (IO_NA_B2), U10.H1 (A8)
SDRAM_A9: U4.C7 (IO_NA_A5), U10.G3 (A9)
SDRAM_A10: U4.B9 (IO_NB_A0), U10.H9 (A10)
SDRAM_A11: U4.B6 (IO_NA_B4), U10.G2 (A11)
SDRAM_A12: U4.B5 (IO_NA_A2), U10.G1 (A12)
SDRAM_BA0: U4.B8 (IO_NA_B7), U10.G7 (BA0)
SDRAM_BA1: U4.C9 (IO_NA_A8), U10.G8 (BA1)
SDRAM_CKE: U4.C8 (IO_NA_A6), U10.F3 (CKE)
SDRAM_CLK: U4.D8 (IO_NA_B6), U10.F2 (CLK)
SDRAM_D0: U4.C14 (IO_NB_B8), U10.A8 (DQ0)
SDRAM_D1: U4.C13 (IO_NB_B6), U10.B9 (DQ1)
SDRAM_D2: U4.D14 (IO_NB_A8), U10.B8 (DQ2)
SDRAM_D3: U4.B12 (IO_NB_A4), U10.C9 (DQ3)
SDRAM_D4: U4.D13 (IO_NB_A6), U10.C8 (DQ4)
SDRAM_D5: U4.B11 (IO_NB_A2), U10.D9 (DQ5)
SDRAM_D6: U4.A12 (IO_NB_B4), U10.D8 (DQ6)
SDRAM_D7: U4.C12 (IO_NB_B5), U10.E9 (DQ7)
SDRAM_D8: U4.B4 (IO_NA_B1), U10.E1 (DQ8)
SDRAM_D9: U4.A3 (IO_NA_A0), U10.D2 (DQ9)
SDRAM_D10: U4.B3 (IO_NA_B0), U10.D1 (DQ10)
SDRAM_D11: U4.C3 (IO_WC_A7), U10.C2 (DQ11)
SDRAM_D12: U4.C4 (IO_WC_B7), U10.C1 (DQ12)
SDRAM_D13: U4.B2 (IO_WC_B8), U10.B2 (DQ13)
SDRAM_D14: U4.B1 (IO_WC_A8), U10.B1 (DQ14)
SDRAM_D15: U4.D4 (IO_WC_B6), U10.A2 (DQ15)
SDRAM_DQM0: U4.A11 (IO_NB_B2), U10.E8 (DQML)
SDRAM_DQM1: U4.A4 (IO_NA_A1), U10.F1 (DQMH)
SDRAM_VCC: C77.1, C78.1, C79.1, C80.1, C85.1, C86.1, C87.1, C88.1, C89.1, C90.1, C91.1, C92.1, C93.1, C99.1, C101.1, C140.1, C141.1, R115.1, R116.1, U4.A2 (VDD_WC), U4.A5 (VDD_NA), U4.B7 (VDD_NA), U4.B10 (VDD_NB), U4.B13 (VDD_NB), U4.C2 (VDD_WC), U4.D5 (VDD_WC), U4.E6 (VDD_NA), U4.E8 (VDD_NA), U4.E10 (VDD_NB), U4.E12 (VDD_NB), U4.F2 (VDD_WC), U4.F5 (VDD_WC), U4.F7 (VDD_NA), U4.F11 (VDD_NB), U10.A7 (VDDQ), U10.A9 (VDD), U10.B3 (VDDQ), U10.C7 (VDDQ), U10.D3 (VDDQ), U10.E7 (VDD), U10.J9 (VDD)
SDRAM_nCAS: U4.D9 (IO_NA_B8), U10.F7 (~CAS)
SDRAM_nCS: U4.C11 (IO_NB_B3), U10.G9 (~CS)
SDRAM_nRAS: U4.A8 (IO_NA_A7), U10.F8 (~RAS)
SDRAM_nWE: U4.D12 (IO_NB_A5), U10.F9 (~WE)
VCC_3V3: C509.1, C511.1, C513.1, JP301.1 (A), L501.2, R503.2, R507.2
VDD_CLK: C4.2, C47.1, C48.1, C126.1, C131.1, C132.1, J4.5, JP303.3 (B), R10.2, R33.1, R34.1, R35.1, R36.1, R38.1, R66.1, R111.1, R116.2, R123.2, R143.1, SW1.1, SW1.2, U4.T14 (VDD_CLK), U6.6 (VCC), U7.8 (VCC), U8.8 (VCC), U9.8 (VCC), X2.6 (VDD), Y1.1, Y1.4
VDD_CORE: C13.1, C14.1, C15.1, C16.1, C17.1, C18.1, C21.1, C22.1, C23.1, C26.1, C27.1, C28.1, C31.1, C32.1, C34.1, C35.1, C37.1, C38.1, C40.1, C41.1, C42.1, C127.1, C128.1, R13.2, R23.1, R105.1, R106.1, U4.F9 (VDD), U4.G6 (VDD), U4.G8 (VDD), U4.G10 (VDD), U4.G12 (VDD), U4.H7 (VDD), U4.H9 (VDD), U4.H11 (VDD), U4.H13 (VDD), U4.J6 (VDD), U4.J8 (VDD), U4.J10 (VDD), U4.J12 (VDD), U4.K7 (VDD), U4.K9 (VDD), U4.K11 (VDD), U4.K13 (VDD), U4.L6 (VDD), U4.L8 (VDD), U4.L10 (VDD), U4.L12 (VDD), U4.M7 (VDD), U4.M9 (VDD), U4.M11 (VDD), U4.M13 (VDD), U4.N6 (VDD), U4.N8 (VDD), U4.N10 (VDD)
VDD_PLL: C33.1, C36.1, C39.1, R23.2, TP6.1 (1_1), U4.P16 (VDD_PLL)
VDD_SER: C121.1, C123.1, C125.1, R9.2, R106.2, TP10.1 (1_1), U4.U12 (VDD_SER), U4.V17 (VDD_SER)
VDD_SER_PLL: C120.1, C122.1, C124.1, R105.2, TP8.1 (1_1), U4.T16 (VDD_SER_PLL)
V_IN_INT: C501.1, C503.1, C505.1, J2.A2 (+12V), J2.A3 (+12V), J2.B1 (+12V), J2.B2 (+12V), J2.B3 (+12V), R501.1, REG501.3 (IN)
