intergalaktik/ulx5-PCIe-1x/(commit log)

2026-10-16 Initial version of 0.2
    [lvds.kicad_sch, power.kicad_sch, ulx5m-m2.kicad_pcb, ulx5m-m2.kicad_sch]
2026-10-19 Update stackup
    [power.kicad_sch, ulx5m-m2.kicad_pcb]
2026-10-19 Adding stackup table
    [ulx5m-m2.kicad_pcb]
2026-10-21 Before adding teardrops
    [ulx5m-m2.kicad_pcb]
2026-10-21 Changing footprint - adding teardrops
    [serdes.kicad_sch, ulx5m-m2.kicad_pcb]
2026-10-21 M2 key update - changing resistors back to 1R
    [power.kicad_sch, ulx5m-m2.kicad_pcb]
2026-10-21 update zones
    [ulx5m-m2.kicad_pcb]
2026-10-21 Adjusting zones
    [ulx5m-m2.kicad_pcb]
2026-10-23 v0.2 - power supply update - update PCIe lines
    [ulx5m-m2.kicad_pcb]
2026-10-23 Update 3D view
    [ulx5m-m2.kicad_pcb]
2026-10-23 lib: Ki-Lime Pi Pico (submodul)
2026-10-29 initial version of ULX5-PCIe-1x
    [HighSpeed.kicad_sch, PCIexpress_connector.kicad_sch, config.kicad_sch, decap.kicad_sch, ethernet.kicad_sch, lvds.kicad_sch, power.kicad_sch, ram.kicad_sch]
2026-10-29 Adding 12V PSU
    [PCIexpress_connector.kicad_sch, decap.kicad_sch, power.kicad_sch, ulx5-PCIe-1x.kicad_pcb]
2026-10-29 Pair switch
    [PCIexpress_connector.kicad_sch, power.kicad_sch, ulx5-PCIe-1x.kicad_pcb]
2026-10-29 power enable fix - connecting AGND
    [power.kicad_sch, raspberry_pico.kicad_sch, serdes.kicad_sch, ulx5-PCIe-1x.kicad_pcb]
2026-10-30 Fixing diff lines
    [PCIexpress_connector.kicad_sch, lvds.kicad_sch, raspberry_pico.kicad_sch, ulx5-PCIe-1x.kicad_pcb, ulx5-PCIe-1x.kicad_sch]
2026-10-30 Adding stackup
    [ulx5-PCIe-1x.kicad_pcb]
