intergalaktik/ulx5-PCIe-1x/(notices)

Notices in the files:
ulx5-PCIe-1x.kicad_sch:
License: ${project_license}
parts and their libraries:
project_license: CERN-OHL-S v2
